ikatkov/fan-control-with-delayed-off/kicad/main-board.kicad_pcb

## KiCad design kicad/main-board.kicad_pcb (2022-08-01)

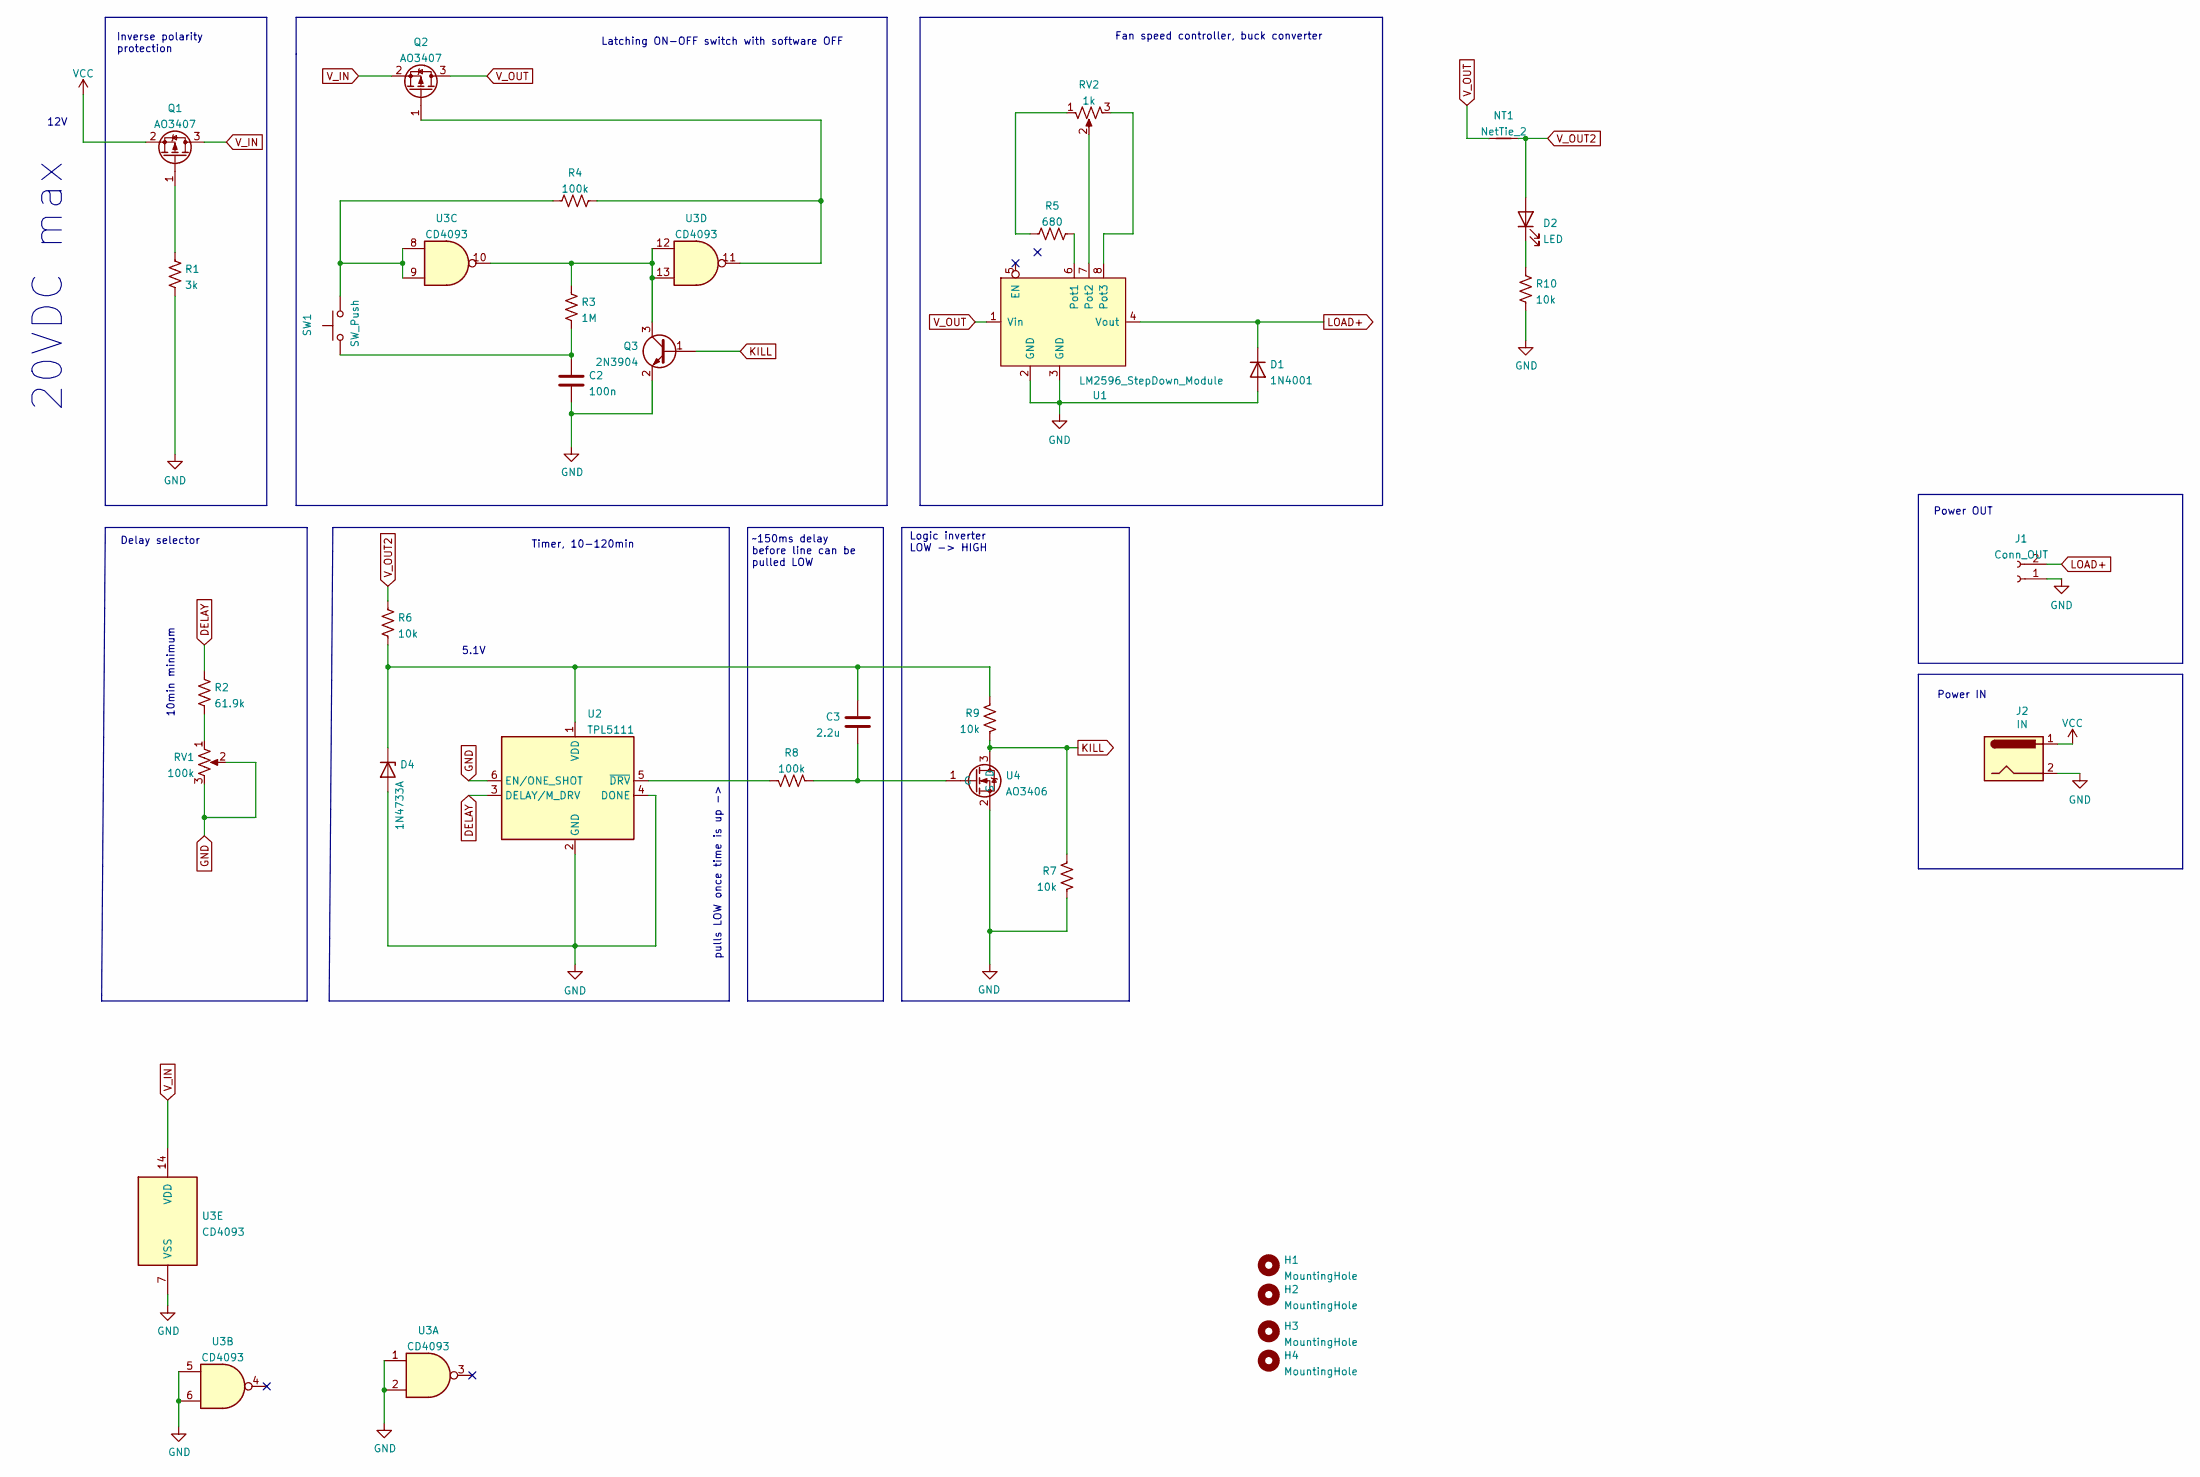
[picture p1: schematic main-board.kicad_sch]

Parts:
C2: 100n; C_1206_3216Metric
C3: 2.2u; C_1206_3216Metric
D1: 1N4001; D_SMB_Handsoldering
D2: LED; LED_D5.0mm
D4: 1N4733A; D_SMA_Handsoldering
H1, H2, H3, H4: MountingHole; MountingHole_3.2mm_M3
J1: Conn_OUT; TerminalBlock_bornier-2_P5.08mm
J2: IN; BarrelJack_Horizontal
NT1: NetTie_2; R_1206_3216Metric_Pad1.30x1.75mm_HandSolder
Q1, Q2: AO3407; SOT-23_Handsoldering
Q3: 2N3904; SOT-23
R1: 3k; R_0805_2012Metric_Pad1.20x1.40mm_HandSolder
R2: 61.9k; R_0805_2012Metric_Pad1.20x1.40mm_HandSolder
R3: 1M; R_0805_2012Metric_Pad1.20x1.40mm_HandSolder
R4, R8: 100k; R_0805_2012Metric_Pad1.20x1.40mm_HandSolder
R5: 680; R_0805_2012Metric_Pad1.20x1.40mm_HandSolder
R6, R7, R9, R10: 10k; R_0805_2012Metric_Pad1.20x1.40mm_HandSolder
RV1: 100k; Potentiometer_RV09_Single_Vertical
RV2: 1k; Potentiometer_RV09_Single_Vertical
SW1: SW_Push; SW_PUSH_6mm
U1: LM2596_StepDown_Module; LM2596_StepDown_pot
U2: TPL5111; SOT-23-6
U3: CD4093; SOIC-14_3.9x8.7mm_P1.27mm
U4: AO3406; SOT-23_Handsoldering

Connections:
DELAY: R2.1, U2.3 (DELAY/M_DRV)
GND: C2.2, D1.2 (A), D4.2 (A), J1.1, J2.2, Q3.2 (E), R1.1, R7.2, R10.2, RV1.2, RV1.3, U1.2 (GND), U1.3 (GND), U2.2 (GND), U2.4 (DONE), U2.6 (EN/ONE_SHOT), U3.1, U3.2, U3.5, U3.6, U3.7 (VSS), U4.2 (S)
KILL: Q3.1 (B), R7.1, R9.2, U4.3 (D)
LOAD+: D1.1 (K), J1.2, U1.4 (Vout)
unnamed: C2.1, R3.1, SW1.1
unnamed: C3.1, D4.1 (K), R6.2, R9.1, U2.1 (VDD)
unnamed: C3.2, R8.2, U4.1 (G)
unnamed: D2.1 (K), R10.1
unnamed: Q1.1 (G), R1.2
unnamed: Q2.1 (G), R4.2, U3.11
unnamed: Q3.3 (C), R3.2, U3.10, U3.12, U3.13
unnamed: R2.2, RV1.1
unnamed: R4.1, SW1.2, U3.8, U3.9
unnamed: R5.1, U1.6 (Pot1)
unnamed: R5.2, RV2.1
unnamed: R8.1, U2.5 (~DRV)
unnamed: RV2.2, U1.7 (Pot2)
unnamed: RV2.3, U1.8 (Pot3)
VCC: J2.1, Q1.2 (S)
V_IN: Q1.3 (D), Q2.2 (S), U3.14 (VDD)
V_OUT: NT1.1, Q2.3 (D), U1.1 (Vin)
V_OUT2: D2.2 (A), NT1.2, R6.1

Notes on the sheet:
Timer, 10-120min
5.1V
Delay selector
Power IN
Fan speed controller, buck converter
Inverse polarity protection
12V
10min minimum
Latching ON-OFF switch with software OFF
20VDC max
Power OUT
~150ms delay before line can be pulled LOW
pulls LOW once time is up ->
Logic inverter LOW -> HIGH

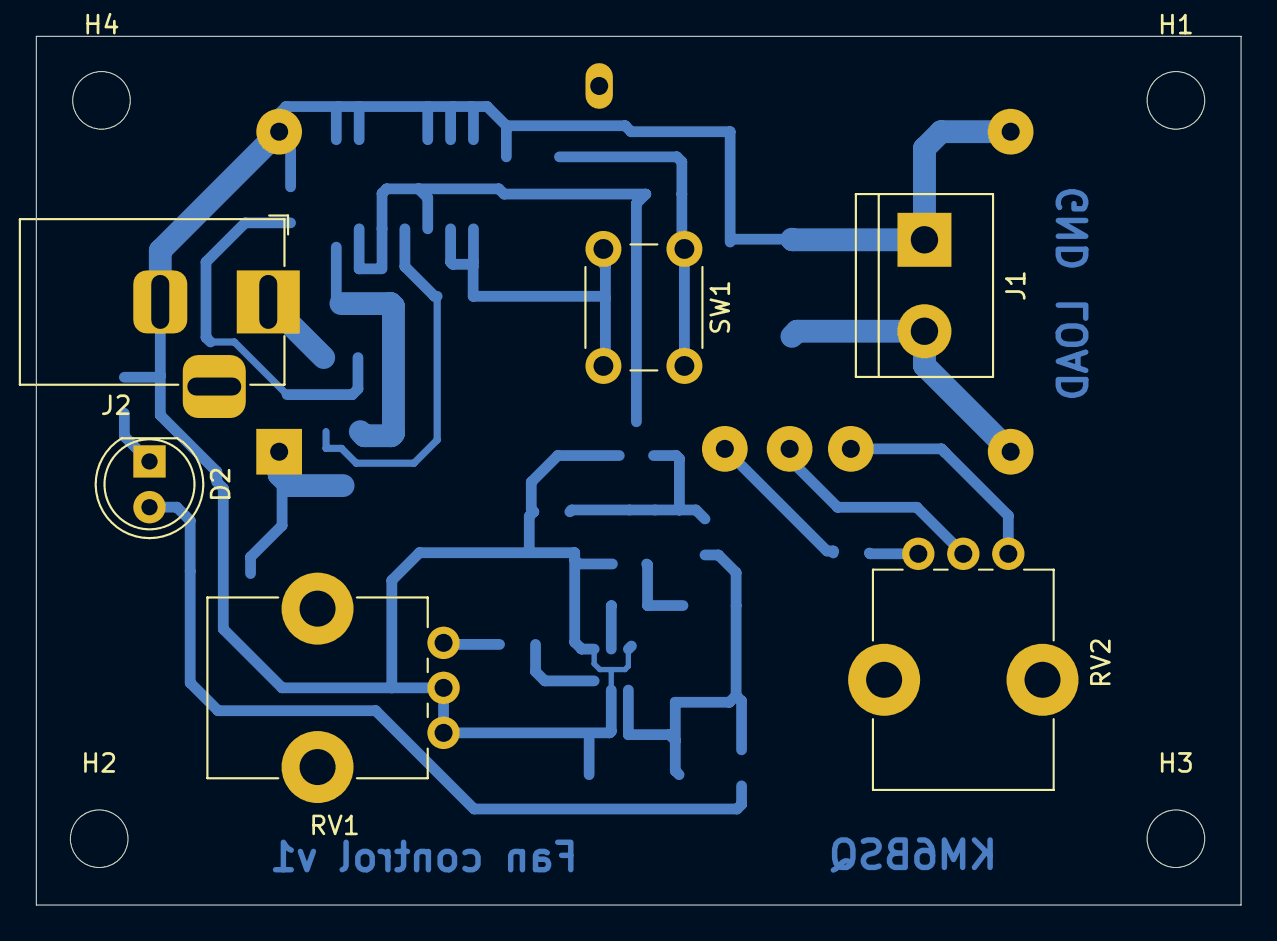
[picture p2: board main-board.kicad_pcb from above]

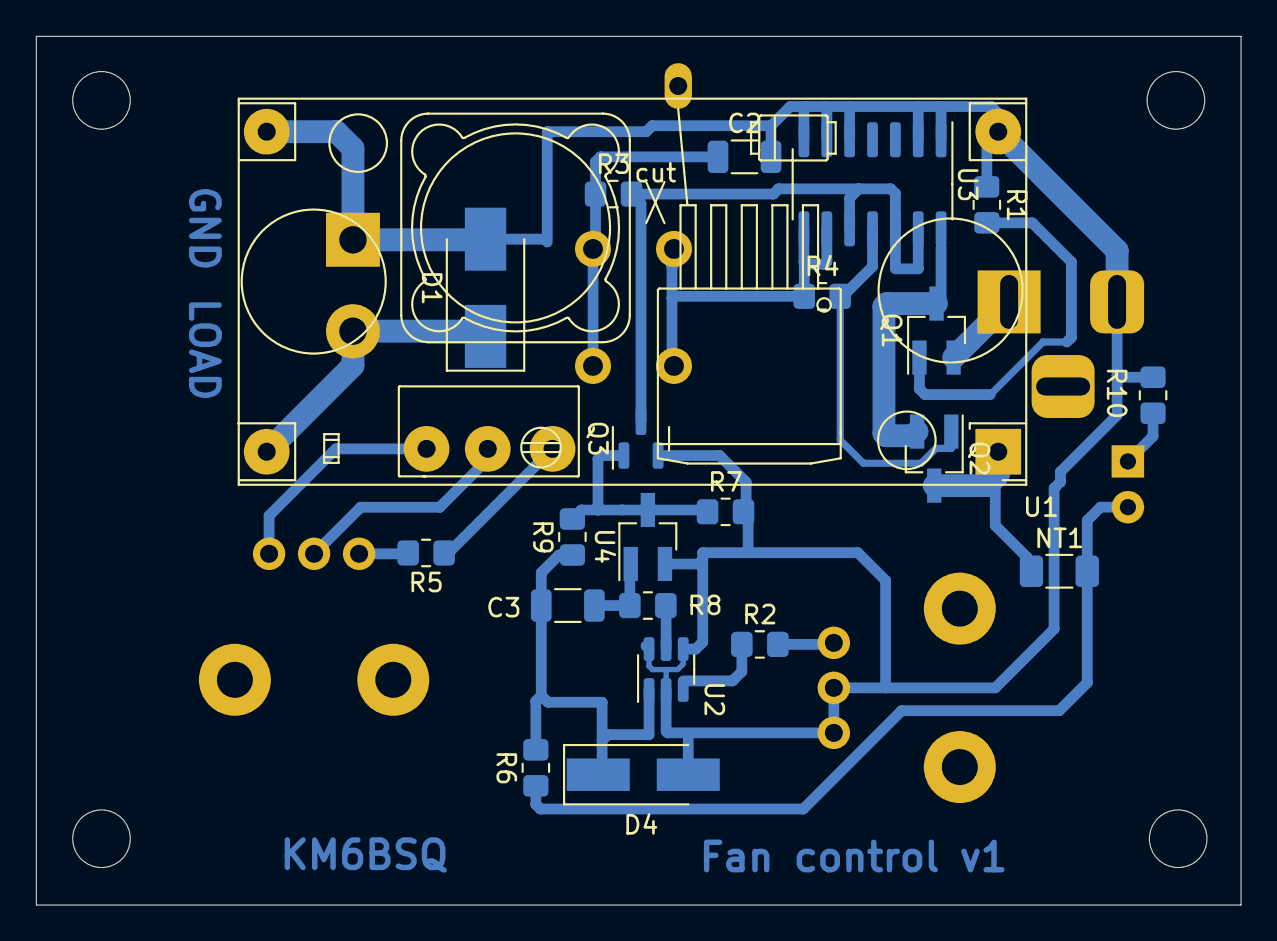
[picture p3: board main-board.kicad_pcb from below]

Board: 4 copper layers, 66.9 x 48.3 mm, 32 parts (22 on the bottom side), 22 nets.
